jwday/remoteProp/Arduino Sketches/propControl_v2/propControl_v2.ino

// propControl_v2.ino
// Last updated 5/6/2020
//
// To be used with the following components:
// - 1x MCP23017 GPIO expansion IC (Uses I2C interface)
// - 1x MCP3008 4-channel ADC IC (Uses SPI interface)
// - 3x L293D motor controller IC (Controlled by MCP23017)
// - (Optional) 1x HX711 Load Cell amplifier + ADC (Uses I2C interface)
//
// NOTE: NodeMCU pins are redefined in a seperate .ino file that gets automatically
// compiled along with this file.

// Wireless communication libraries
#include <ESP8266WiFi.h>        // WiFi Library
#include <MQTT.h>               // MQTT Library by Joel Gaehwiler, https://github.com/256dpi/arduino-mqtt
#include <Wire.h>               // I2C Library
#include <Adafruit_MCP23017.h>  // MCP23017 GPIO Expansion board library (uses I2C)
#include <SPI.h>                // SPI Library
#include <MCP3XXX.h>            // MCP3XXX ADC library, used for any MCP3XXX series ADC (uses SPI)


// What SSID do you want to connect to, and what's the password?
// Note: Local domain names (e.g. "Computer.local" on OSX) are not supported by Arduino.
// You need to set the IP address of the broker directly.
const char ssid[] = "SSID";
const char pass[] = "password";
const char ip_address[] = "192.168.0.200";  // Via Apogee to Raspberry Pi broker


// Variables for controlling pressure XDCR publish rate, ADC read variables, and ADC timing variables
float pubRate = 100;
int adc_value1;
int adc_value2;
unsigned long adc_read_pre;
unsigned long adc_read_post;
unsigned long adc_readTime;


// Variables for commanding a prescribed valve-open time
bool holdOpenSwitch = false;
unsigned long commandedBurnTimeMicros;
unsigned long openedMicros;  // The time at which the valve was commanded to be opened


// Instantiate the valveID variable
int valveID;


// Variables for timekeeping while performing "parallel" processes
unsigned long currentMillis;
unsigned long currentMicros;
unsigned long previousMillis = 0;
unsigned long previousMicros = 0;
int n = 1;
unsigned long averageTime = 0;
unsigned long sampleTime;
unsigned long average_adc = 0;
unsigned long adc_value;


// Instantiate all the required objects
WiFiClient net;             // Instantiate a WiFiClient object, call it "net"
MQTTClient client;          // Instantiate an MQTTClient object, call it "client"
MCP3002 adc;                // Instantiate an MCP3008 ADC object, assuming it's connected to the default pins D5, D6, D7, D8, call it "adc"
Adafruit_MCP23017 GPIO_IC;  // Instantiate an MCP23017 GPIO Expansion object


void timedPropel() {
    currentMicros = micros();
    if (currentMicros - openedMicros >= commandedBurnTimeMicros) {
        unsigned long actualBurnTime = currentMicros - openedMicros;
        GPIO_IC.digitalWrite(0, LOW);
        holdOpenSwitch = false;
        client.publish("timedPropelReturn", String(actualBurnTime));
        Serial.print("Opened Time is ");
        Serial.println(openedMicros);
        Serial.print("Closed Time is ");
        Serial.println(currentMicros);
        Serial.println("");
        Serial.print("Thrust command complete. Thrust held for ");
        Serial.print(actualBurnTime);
        Serial.println(" microseconds.");
    }
}


void connect() {
    WiFi.hostname("propcontroller");
    WiFi.begin(ssid, pass);
    Serial.print("Attempting to connect to ");
    Serial.println(ssid);

    while (WiFi.status() != WL_CONNECTED) {
        Serial.print(".");
        delay(500);
    }

    if (WiFi.status() == WL_CONNECTED) {
        Serial.print("\nWiFi connected to ");
        Serial.println(WiFi.SSID());
        Serial.print("IP address: ");
        Serial.println(WiFi.localIP());
        Serial.print("Gateway: ");
        Serial.println(WiFi.gatewayIP());
        Serial.println("");
    }

    Serial.println("Connecting to broker...");
    client.begin(ip_address, net);

    while (!client.connect("propcontroller")) {
        Serial.print(".");
        delay(1000);
    }

    Serial.println("Connected to broker!");
    client.subscribe("singleValveOn");
    client.subscribe("singleValveOff");
    client.subscribe("propel");
    client.subscribe("refill");
    client.subscribe("timedPropel");
    client.subscribe("getValveStates");
}

    
void messageReceived(String &topic, String &payload) {
    Serial.println("incoming: " + topic + " - " + payload);

    // For valveDebug only
    if (topic == "singleValveOn" || topic == "singleValveOff") {
        valveID = payload.toInt() - 1;  // Because GPIO incrementation begins at 0 while valveIDs begin at 1
  
        // Valve ON
        if (topic == "singleValveOn") {
            GPIO_IC.digitalWrite(valveID, HIGH);
            digitalWrite(2, LOW);  // Will turn LED ON when an open valve command is sent
        }
    
        // Valve OFF
        if (topic == "singleValveOff") {
            GPIO_IC.digitalWrite(valveID, LOW);
            digitalWrite(2, HIGH);  // Will turn LED OFF when a close valve command is sent
        }
    }
    
    // Prescribed time, currently only available for Valve #1
    if (topic == "timedPropel") {
        holdOpenSwitch = true;
        commandedBurnTimeMicros = (unsigned long)(payload.toFloat() * 1000000.0);
        Serial.print("Hold-open command received. Thrust for ");
        Serial.print(commandedBurnTimeMicros);
        Serial.println(" microseconds.");
        openedMicros = micros();
        GPIO_IC.digitalWrite(0, HIGH);
        timedPropel();  // Only sending "openedTime" because the function requires a number to be passed
    }

    // Propel commands
    else if (topic == "propel") {
        if (payload == "fwd") {
          // Valves 3 and 12 (GPIO 2 and 11)
          GPIO_IC.digitalWrite(2, HIGH);
          GPIO_IC.digitalWrite(11, HIGH);
          digitalWrite(2, LOW);  // Will turn LED ON when an open valve command is sent
        }
        
        if (payload == "xtrafwd") {
          // Valves 2, 3 and 11, 12 (GPIO 1, 2 and 10, 11)
          GPIO_IC.digitalWrite(1, HIGH);
          GPIO_IC.digitalWrite(2, HIGH);
          GPIO_IC.digitalWrite(10, HIGH);
          GPIO_IC.digitalWrite(11, HIGH);
          digitalWrite(2, LOW);  // Will turn LED ON when an open valve command is sent
        }   
        
        if (payload == "bckwd") {
          // Valves 6 and 9 (GPIO 5 and 8)
          GPIO_IC.digitalWrite(5, HIGH);
          GPIO_IC.digitalWrite(8, HIGH);
          digitalWrite(2, LOW);  // Will turn LED ON when an open valve command is sent
        }
        
        if (payload == "xtrabckwd") {
          // Valves 5, 6 and 8, 9 (GPIO 4, 5 and 7, 8)
          GPIO_IC.digitalWrite(4, HIGH);
          GPIO_IC.digitalWrite(5, HIGH);
          GPIO_IC.digitalWrite(7, HIGH);
          GPIO_IC.digitalWrite(8, HIGH);
          digitalWrite(2, LOW);  // Will turn LED ON when an open valve command is sent
        }
                
        if (payload == "panleft") {
          // Valves 3 and 6 (GPIO 2 and 5)
          GPIO_IC.digitalWrite(2, HIGH);
          GPIO_IC.digitalWrite(5, HIGH);
          digitalWrite(2, LOW);  // Will turn LED ON when an open valve command is sent
        }

        if (payload == "xtrapanleft") {
          // Valves 2, 3 and 5, 6 (GPIO 1, 2 and 4, 5)
          GPIO_IC.digitalWrite(1, HIGH);
          GPIO_IC.digitalWrite(2, HIGH);
          GPIO_IC.digitalWrite(4, HIGH);
          GPIO_IC.digitalWrite(5, HIGH);
          digitalWrite(2, LOW);  // Will turn LED ON when an open valve command is sent
        }
        
        if (payload == "panright") {
          // Valves 9 and 12 (GPIO 8 and 11)
          GPIO_IC.digitalWrite(8, HIGH);
          GPIO_IC.digitalWrite(11, HIGH);
          digitalWrite(2, LOW);  // Will turn LED ON when an open valve command is sent
        }

        if (payload == "xtrapanright") {
          // Valves 8, 9 and 11, 12 (GPIO 7, 8 and 10, 11)
          GPIO_IC.digitalWrite(7, HIGH);
          GPIO_IC.digitalWrite(8, HIGH);
          GPIO_IC.digitalWrite(10, HIGH);
          GPIO_IC.digitalWrite(11, HIGH);
          digitalWrite(2, LOW);  // Will turn LED ON when an open valve command is sent
        }
    
        if (payload == "turnleft") {
          // Valves 6 and 12 (GPIO 5 and 11)
          GPIO_IC.digitalWrite(5, HIGH);
          GPIO_IC.digitalWrite(11, HIGH);
          digitalWrite(2, LOW);  // Will turn LED ON when an open valve command is sent
        }

        if (payload == "xtraturnleft") {
          // Valves 5, 6 and 11, 12 (GPIO 4, 5 and 10, 11)
          GPIO_IC.digitalWrite(4, HIGH);
          GPIO_IC.digitalWrite(5, HIGH);
          GPIO_IC.digitalWrite(10, HIGH);
          GPIO_IC.digitalWrite(11, HIGH);
          digitalWrite(2, LOW);  // Will turn LED ON when an open valve command is sent
        }
    
        if (payload == "turnright") {
          // Valves 3 and 9 (GPIO 2 and 8)
          GPIO_IC.digitalWrite(2, HIGH);
          GPIO_IC.digitalWrite(8, HIGH);
          digitalWrite(2, LOW);  // Will turn LED ON when an open valve command is sent
        }

        if (payload == "xtraturnright") {
          // Valves 2, 3 and 8, 9 (GPIO 1, 2 and 7, 8)
          GPIO_IC.digitalWrite(1, HIGH);
          GPIO_IC.digitalWrite(2, HIGH);
          GPIO_IC.digitalWrite(7, HIGH);
          GPIO_IC.digitalWrite(8, HIGH);
          digitalWrite(2, LOW);  // Will turn LED ON when an open valve command is sent
        }
    
        if (payload == "turnoff") {
          // All valves off
          for (int valveID=0; valveID<12; valveID++) {
            GPIO_IC.digitalWrite(valveID, LOW); 
          }
          digitalWrite(2, HIGH);  // Will turn LED ON when an open valve command is sent
        }
    }

    // Refill commands
    if (topic == "refill") {
        if (payload == "fwd") {
          // Valves 1, 2 and 10, 11 (GPIO 0, 1 and 9, 10)
          GPIO_IC.digitalWrite(0, HIGH);
          GPIO_IC.digitalWrite(1, HIGH);
          GPIO_IC.digitalWrite(9, HIGH);
          GPIO_IC.digitalWrite(10, HIGH);
          digitalWrite(2, LOW);  // Will turn LED ON when an open valve command is sent
        }
    
        if (payload == "bckwd") {
          // Valves 4, 5 and 7, 8 (GPIO 3, 4 and 6, 7)
          GPIO_IC.digitalWrite(3, HIGH);
          GPIO_IC.digitalWrite(4, HIGH);
          GPIO_IC.digitalWrite(6, HIGH);
          GPIO_IC.digitalWrite(7, HIGH);
          digitalWrite(2, LOW);  // Will turn LED ON when an open valve command is sent
        }
        
        if (payload == "panleft") {
          // Valves 1, 2 and 4, 5 (GPIO 0, 1 and 3, 4)
          GPIO_IC.digitalWrite(0, HIGH);
          GPIO_IC.digitalWrite(1, HIGH);
          GPIO_IC.digitalWrite(3, HIGH);
          GPIO_IC.digitalWrite(4, HIGH);
          digitalWrite(2, LOW);  // Will turn LED ON when an open valve command is sent
        }
        
        if (payload == "panright") {
          // Valves 7, 8 and 10, 11 (GPIO 6, 7 and 9, 10)
          GPIO_IC.digitalWrite(6, HIGH);
          GPIO_IC.digitalWrite(7, HIGH);
          GPIO_IC.digitalWrite(9, HIGH);
          GPIO_IC.digitalWrite(10, HIGH);
          digitalWrite(2, LOW);  // Will turn LED ON when an open valve command is sent
        }
    
        if (payload == "turnleft") {
          // Valves 4, 5 and 10, 11 (GPIO 3, 4 and 9, 10)
          GPIO_IC.digitalWrite(3, HIGH);
          GPIO_IC.digitalWrite(4, HIGH);
          GPIO_IC.digitalWrite(9, HIGH);
          GPIO_IC.digitalWrite(10, HIGH);
          digitalWrite(2, LOW);  // Will turn LED ON when an open valve command is sent
        }
    
        if (payload == "turnright") {
          // Valves 1, 2 and 7, 8 (GPIO 0, 1 and 6, 7)
          GPIO_IC.digitalWrite(0, HIGH);
          GPIO_IC.digitalWrite(1, HIGH);
          GPIO_IC.digitalWrite(6, HIGH);
          GPIO_IC.digitalWrite(7, HIGH);
          digitalWrite(2, LOW);  // Will turn LED ON when an open valve command is sent
        }
    
        if (payload == "turnoff") {
          // All valves off
          for (int valveID=0; valveID<12; valveID++) {
            GPIO_IC.digitalWrite(valveID, LOW); 
          }
          digitalWrite(2, HIGH);  // Will turn LED ON when an open valve command is sent
        }
    }

    // Return Valve States
    if (topic == "getValveStates") {
      for (int valveID=0; valveID<12; valveID++) {            // Cycle through all valves
        if (GPIO_IC.digitalRead(valveID) == HIGH) {           // If a valve is HIGH
          client.publish("valveStateOn", String(valveID));    // Publish the ID of that valve under topic "valveStateOn"
        }
      }
    }
}


void setup() {
    pinMode(2, OUTPUT);  // This is the LED_BUILTIN pin, used for debugging
    digitalWrite(2, HIGH);  // Default to OFF
    
    Serial.begin(9600);
    Wire.begin();
    adc.begin();
    
//     Set up MCP23017. 
//          A0  A1  A2  Address
//          L   L   L   0
//          H   L   L   1
//          L   H   L   2
//          H   H   L   3
//          etc...

    GPIO_IC.begin(0);      // use address 0 (note that leaving it blank will also set it to address 0)
    for (int i = 0; i <= 11; i++) {
        GPIO_IC.pinMode(i, OUTPUT);
    }
    
    connect();
    client.onMessage(messageReceived);
}



void avgSampleFreq(float sampleTime) {
    averageTime = (averageTime*(n-1) + sampleTime)/n;
    if (n >= 20) {
        Serial.print("Average loop time (" + String(n) + " loops): ");
        Serial.print(String(averageTime) + " us");
        Serial.println(" (" + String(1000000.0/averageTime) + " Hz)");
        n = 0;
    }
    n++;
}


void avgPressure(float adc_value) {
    average_adc = (average_adc*(n-1) + adc_value)/n;
    if (n >= 20) {
        Serial.print("Average adc (" + String(n) + " loops): ");
        Serial.println(String(average_adc));
        n = 0;
    }
    n++;
}


void loop() {
    // This loop takes ~10.2 ms to complete when reading from ADC (~98 Hz) when delay = 10
    // This loop takes ~5.13 ms to complete when reading from ADC (~195 Hz) when delay = 5
    adc_read_pre = micros();
    client.loop();
    delay(5);  // <- fixes some issues with WiFi stability, but kills the sample rate

    if (!client.connected()) {
        for (int i=0; i<12; i++) {
            GPIO_IC.digitalWrite(i, LOW);  // Cycle through all 16 pins and shut them down. NOTE: This is specific to the Adafruit_MCP23017 library.
        }
        connect(); // Attempt to connect
    }

    currentMillis = millis();

    if (currentMillis - previousMillis >= pubRate) {
        // This loop takes ~1.2 ms to complete (~830 Hz)
        
        // Pressure XDCRs
        adc_value1 = adc.analogRead(0);  // Float pressure
        adc_value2 = adc.analogRead(1);  // Prop pressure

        // ADC1:    0 PSIG: 82      100PSIG: 782
        // ADC2:    0 PSIG: 98      100PSIG: 264  Something is very wrong here

        // ADC1: 100/(782-82) = 0.14286
        // ADC2: 100/(264-98) = 0.60241
        float float_psig = (adc_value1 - 82) * 0.14286;
        float prop_psig = (adc_value2 - 98) * 0.60241;

        client.publish("float_pressure", String(float_psig));
        client.publish("prop_pressure", String(prop_psig));

        Serial.print("adc1: " + String(adc_value1));
        Serial.print("     float_psig: " + String(float_psig)); 
        Serial.print("     adc2: " + String(adc_value2));
        Serial.println("     prop_psig: " + String(prop_psig));

        previousMillis = currentMillis;
//        avgPressure(adc_value0);
    }

    if (holdOpenSwitch) {
        timedPropel();
    }
    
    adc_read_post = micros();
    adc_readTime = adc_read_post - adc_read_pre;
//    avgSampleFreq(adc_readTime);
}
