jwday/remoteProp/Arduino Sketches/propControl_v2/NodeMCU_redefinePins.ino

// Because I'm using a NodeMCU Amica microcontroller (which uses some other chipset), I
// need to redefine the pins to match how they're labeled on the board.
// For example: Pin D7 on the NodeMCU Amica actually corresponds to Pin 13 in the code.
// I don't know why this is a thing, but it is.
// The reassignment below was pulled from a github discussion forum.
// Now, instead of referring to Pin 13, call it Pin D7 (for example).
#define D0 16 
#define D1 5  // I2C Bus SCL (clock), also the clock for the thermocouple
#define D2 4  // I2C Bus SDA (data) Chip select (CS) pin for thermocouple
#define D3 0  // Data out pin (DO) for thermocouple
#define D4 2  // Same as "LED_BUILTIN", but inverted logic
#define D5 14 // SPI Bus SCK (clock)
#define D6 12 // SPI Bus MISO
#define D7 13 // SPI Bus MOSI 
#define D8 15 // SPI Bus SS (CS)
#define D9 3  // RX0 (Serial console)
#define D10 1 // TX0 (Serial console)
