jwday/remoteProp/(commit log)

2018-04-25 Control LED from phone
2018-04-25 Added buttons and functions
2018-05-05 Added Arduino controller code
2018-05-05 Added safeguards to close valve upon disconnects
2019-03-16 now i can measure pressure
2019-10-24 Updated Arduino to pass holdOpenTime
2019-10-24 Fixed Arduino Return I hope
2019-10-25 Updated index.html to display millis
2019-10-25 Updated propControl.ino to send Millis
2019-11-15 Added thermocouple arduino code for reference
    [20191114_124818_testdata.csv, 20191114_133552_testdata.csv]
2019-11-15 Fixed rounding error on index.html
    [20191114_183619_testdata.csv, 20191114_18468_float_data.csv, 20191114_18468_prop_data.csv, 20191114_184753_float_data.csv, 20191114_184753_prop_data.csv, 20191114_185426_float_data.csv, 20191114_185426_prop_data.csv, 20191114_185641_float_data.csv]
2019-11-15 Dont round, and 10Hz
2019-11-16 Capture data before and after command
    [20191114_124818_testdata.csv, 20191114_133552_testdata.csv, 20191114_183619_testdata.csv, 20191114_18468_float_data.csv, 20191114_18468_prop_data.csv, 20191114_184753_float_data.csv, 20191114_184753_prop_data.csv, 20191114_185426_float_data.csv]
2019-11-28 Added temp and weight sensors
2019-11-28 Feather HUZZAH, load cell, temperature
2019-11-28 New data
    [20191127_194715_float_data.csv, 20191127_194715_loadcell_data.csv, 20191127_194715_prop_data.csv, 20191127_194715_temp_data.csv, 20191127_195635_float_data.csv, 20191127_195635_loadcell_data.csv, 20191127_195635_prop_data.csv, 20191127_195635_temp_data.csv]
2019-11-29 Data lots of data
    [20191129_143450_float_data.csv, 20191129_143450_loadcell_data.csv, 20191129_143450_prop_data.csv, 20191129_143450_temp_data.csv, 20191129_143559_float_data.csv, 20191129_143559_loadcell_data.csv, 20191129_143559_prop_data.csv, 20191129_143559_temp_data.csv]
2019-11-30 more data
    [20191130_120249_float_data.csv, 20191130_120249_loadcell_data.csv, 20191130_120249_prop_data.csv, 20191130_120249_temp_data.csv]
2019-11-30 prop psi to weight
2019-11-30 newer data
    [20191130_131419_float_data.csv, 20191130_131419_loadcell_data.csv, 20191130_131419_prop_data.csv, 20191130_131419_temp_data.csv, 20191130_131515_float_data.csv, 20191130_131515_loadcell_data.csv, 20191130_131515_prop_data.csv, 20191130_131515_temp_data.csv]
2019-11-30 minor updates to prop control
2019-12-06 updated plot_data
    [20191205_191402_float_data.csv]
2019-12-24 xmas eve eve data
    [20191219_205802_float_data.csv, 20191219_205802_loadcell_data.csv, 20191219_205802_prop_data.csv, 20191219_205802_temp_data.csv, 20191219_205915_float_data.csv, 20191219_205915_loadcell_data.csv, 20191219_205915_prop_data.csv, 20191219_205915_temp_data.csv]
2019-12-28 Corrected thrust code working
2020-01-15 Added valve debug capability
2020-01-21 Added valve debug and links
2020-01-30 Corrections to multiple code blocks
    [testStand.ino, valveDebug.ino]
2020-02-12 fixed arduino bugs
2020-04-24 update for 12 valves and gpio
2020-07-09 Fixed IP address to 192.168.0.200
    [propControl_v2.ino]
2020-07-09 updated pressure XDCR calibration values
2020-07-18 prop xdcr new calibration
2020-07-22 valve toggle
2020-07-24 modified valveToggle names
2020-07-29 revamped pres+thrust vs time over 5 setpoints graph
    [20191204_143735_float_data.csv, 20191204_143735_loadcell_data.csv, 20191204_143735_prop_data.csv, 20191204_143817_loadcell_data.csv, 20191204_143931_loadcell_data.csv, 20191204_145400_loadcell_data.csv, 20191204_145419_loadcell_data.csv, 20191204_145442_float_data.csv]
